kmc97/Palmeri-EKG/(commit log)

2017-11-24 first code includes two int functions and two LED Hz settings
2017-12-10 COmpleted interrupt fxn, digital signal
